barbarachbc/wilson-fuzz/README.md

# wilson-fuzz
Wilson Fuzz (a Fuzz Face clone)
