barbarachbc/wilson-fuzz/Production/25 - MouserBom.xls

Mfr Part Number (Input) | Quantity 1 | Mfr Part Number | Mouser Part Number | Manufacturer Name | Description | Unit Price 1 | Order Quantity | Order Unit Price | Min./Mult. | Availability | Lead Time in Days | Lead Time in Weeks | Lifecycle | NCNR | RoHS | Pb Free | Package Type | Package Quantity | Datasheet URL | Product Image | Design Risk
603-MFR25SFTF52-330R | 1
603-MFR25SFTF26-33K | 1
603-MFR25SFRF52-100K | 1
603-MFR25SFTF52-8K2 | 1
603-MFR25SFTF52-10K | 1
652-PDB181-E420K102B | 1 | PDB181-E420K-102B | 652-PDB181-E420K102B | Bourns | Potentiometers Potentiometers 1K SINGLE | €1.41 | 1 | €1.41 | 1\1 | 1,061 | 98 | 14 |  | No | Yes | Yes | TRAY | 50 | https://www.mouser.com/datasheet/2/54/PDB18-1013655.pdf |  | Product has high popularity and is readily available.
652-PDB181-E420K504B | 1
5164-1231-L | 2
512-BC549CTA | 2 | BC549CTA | 512-BC549CTA | onsemi | Bipolar Transistors - BJT Bipolar Transistors - BJT NPN 30V 100mA | €0.344 | 2 | €0.344 | 1\1 | 187,925 | 161 | 23 |  | No | Yes | Yes | AMMO PACK | 2,000 | https://www.mouser.com/datasheet/2/308/1/BC550_D-2310266.pdf |  | Product has high popularity and is readily available.
612-FS573PLT2B2M1QEH | 1 | FS57003PLT2B2M1QEH | 612-FS573PLT2B2M1QEH | E-Switch | Foot Switches Foot Switches PUSHBUTTON, 1A 9VDC, 3PDT On-On, Panel Mount, Rear Solder | €7.34 | 1 | €7.34 | 1\1 | 82 | 84 | 12 |  | No | Yes | Yes | BULK | 27 | https://configured-product-images.s3.amazonaws.com/2D/specs/FS57003PLT2B2M1QEH.pdf |  | Product has high popularity and is readily available.
502-111X | 2 | 111X | 502-111X | Switchcraft | Phone Connectors Phone Connectors 2C ENCLOSED 1/4" | €2.97 | 2 | €2.97 | 1\1 | 2,840 | 70 | 10 |  | No | Yes | No |  | 500 | https://www.mouser.com/datasheet/2/393/nl110x_mnl110x_series_cd-2943135.pdf |  | Product has high popularity and is readily available.
546-1590A | 1 | 1590A | 546-1590A | Hammond | Enclosures, Boxes, & Cases Enclosures, Boxes, & Cases Diecast Unpainted 3.64 x 1.52 x 1.06" | €7.65 | 1 | €7.65 | 1\1 | 1,060 |  |  |  | No | Yes | No |  | 1 | https://www.mouser.com/datasheet/2/177/1590-1283706.pdf |  | Product has high popularity and is readily available.
MFR-25FRF52-33K | 1 | MFR-25FRF52-33K | 603-MFR-25FRF52-33K | YAGEO | Metal Film Resistors - Through Hole Metal Film Resistors - Through Hole 33K OHM 1/4W 1% | €0.093 | 1 | €0.093 | 1\1 | 11,994 | 98 | 14 |  | No | Yes | Yes | REEL | 5,000 | https://www.mouser.com/datasheet/2/447/YAGEO_MFR_datasheet_2023v3-3324391.pdf |  | Product has high popularity and is readily available.
MFR-25FRF52-330R | 1 | MFR-25FRF52-330R | 603-MFR-25FRF52-330R | YAGEO | Metal Film Resistors - Through Hole Metal Film Resistors - Through Hole 330 OHM 1/4W 1% | €0.093 | 1 | €0.093 | 1\1 |  | 161 | 23 |  | No | Yes | Yes | REEL | 5,000 | https://www.mouser.com/datasheet/2/447/YAGEO_MFR_datasheet_2023v3-3324391.pdf |  | Product has high popularity and is readily available.
MFR-25FRF52-100K | 1 | MFR-25FRF52-100K | 603-MFR-25FRF52100K | YAGEO | Metal Film Resistors - Through Hole Metal Film Resistors - Through Hole 100K ohm 1/4W 1% | €0.093 | 1 | €0.093 | 1\1 | 28,105 | 161 | 23 |  | No | Yes | Yes | REEL | 5,000 | https://www.mouser.com/datasheet/2/447/YAGEO_MFR_datasheet_2023v3-3324391.pdf |  | Product has high popularity and is readily available.
MFR-25FRF52-8K2 | 1 | MFR-25FRF52-8K2 | 603-MFR-25FRF52-8K2 | YAGEO | Metal Film Resistors - Through Hole Metal Film Resistors - Through Hole 8.2K OHM 1/4W 1% | €0.093 | 1 | €0.093 | 1\1 | 15,995 | 168 | 24 |  | No | Yes | Yes | REEL | 5,000 | https://www.mouser.com/datasheet/2/447/YAGEO_MFR_datasheet_2023v3-3324391.pdf |  | Product has high popularity and is readily available.
MFR-25FRF52-10K | 1 | MFR-25FRF52-10K | 603-MFR-25FRF5210K | YAGEO | Metal Film Resistors - Through Hole Metal Film Resistors - Through Hole 10 kOhms 250 mW 1% 100 PPM / C | €0.093 | 1 | €0.093 | 1\1 |  | 70 | 10 |  | No | Yes | Yes | REEL | 5,000 | https://www.mouser.com/datasheet/2/447/YAGEO_MFR_datasheet_2023v3-3324391.pdf |  | Product has high popularity and is readily available.
710-860020672006 | 1 | 860020672006 | 710-860020672006 | Wurth Elektronik | Aluminum Electrolytic Capacitors - Radial Leaded Aluminum Electrolytic Capacitors - Radial Leaded WCAP-ATG5 2.2uF 50V 20% Radial | €0.102 | 1 | €0.102 | 1\1 | 4,833 | 31 | 5 |  | No | Yes | Yes | AMMO PACK | 2,000 | https://www.we-online.com/components/products/datasheet/860020672006.pdf |  | Product has high popularity and is readily available.
710-860020672011 | 1 | 860020672011 | 710-860020672011 | Wurth Elektronik | Aluminum Electrolytic Capacitors - Radial Leaded Aluminum Electrolytic Capacitors - Radial Leaded WCAP-ATG5 22uF 50V 20% Radial | €0.102 | 1 | €0.102 | 1\1 | 5,759 |  |  |  | No | Yes | Yes | AMMO PACK | 2,000 | https://www.we-online.com/components/products/datasheet/860020672011.pdf |  | Product has high popularity and is readily available.
710-860020472006 | 1 | 860020472006 | 710-860020472006 | Wurth Elektronik | Aluminum Electrolytic Capacitors - Radial Leaded Aluminum Electrolytic Capacitors - Radial Leaded WCAP-ATG5 47uF 25V 20% Radial | €0.093 | 1 | €0.093 | 1\1 | 17,221 |  |  |  | No | Yes | Yes | AMMO PACK | 2,000 | https://www.we-online.com/components/products/datasheet/860020472006.pdf |  | Product has high popularity and is readily available.
710-151031SS04000 | 1 | 151031SS04000 | 710-151031SS04000 | Wurth Elektronik | Standard LEDs - Through Hole Standard LEDs - Through Hole WL-TMRC THT Mono Diffusd Rnd3mm SprRd | €0.167 | 1 | €0.167 | 1\1 | 4,918 |  |  |  | No | Yes | Yes | BULK | 500 | https://www.we-online.com/components/products/datasheet/151031SS04000.pdf |  | Product has high popularity and is readily available.
871-B32529C103J | 1 | B32529C103J | 871-B32529C103J | TDK | Film Capacitors Film Capacitors 0.01uF 63volts 5% | €0.288 | 1 | €0.288 | 1\1 |  | 126 | 18 |  | No | Yes | Yes | BULK | 2,000 | https://www.tdk-electronics.tdk.com/inf/20/20/db/fc_2009/B32520_529.pdf |  | Product has high popularity and is readily available.
652-PDB181E415K504A2 | 1 | PDB181-E415K-504A2 | 652-PDB181E415K504A2 | Bourns | Potentiometers Potentiometers PANEL CONTROL 17MM-ST-CARBON | €1.42 | 1 | €1.42 | 1\1 | 533 | 98 | 14 |  | No | Yes | Yes | TRAY | 50 | https://www.mouser.com/datasheet/2/54/PDB18-1013655.pdf |  | Product has high popularity and is readily available.
836-10781 | 4 | 10781 | 836-10781 | Heyco | Standoffs & Spacers Standoffs & Spacers HCBS-08M-AB NATURAL NYL PCB Support ADH | €0.54 | 4 | €0.54 | 1\1 | 6,414 | 15 | 3 |  | No | Yes | No |  | 1,000 | https://www.mouser.com/datasheet/2/184/7-27_115-909012.pdf |  | Product has high popularity and is readily available.
652-PDB181-K420K102B | 1 | PDB181-K420K-102B | 652-PDB181-K420K102B | Bourns | Potentiometers Potentiometers 1K SINGLE | €1.41 | 1 | €1.41 | 1\1 | 785 | 98 | 14 |  | No | Yes | Yes | TRAY | 50 | https://www.mouser.com/datasheet/2/54/PDB18-1013655.pdf |  | Product has high popularity and is readily available.
652-PDB181-K420K504A | 1 | PDB181-K420K-504A | 652-PDB181-K420K504A | Bourns | Potentiometers Potentiometers 500K SINGLE | €1.15 | 1 | €1.15 | 1\1 | 352 | 98 | 14 |  | No | Yes | Yes | BULK | 75 | https://www.mouser.com/datasheet/2/54/PDB18-1013655.pdf |  | Product has high popularity and is readily available.
PJ-011A | 1 | PJ-011A | 490-PJ-011A | CUI Devices | DC Power Connectors DC Power Connectors Power Jacks | €1.88 | 1 | €1.88 | 1\1 | 2,555 | 91 | 13 |  | No | Yes | No |  | 300 | https://www.mouser.com/datasheet/2/670/pj_011a-1778135.pdf |  | Product has high popularity and is readily available.
5164-1227-L | 2 | 1227-L | 5164-1227-L | Davies Molding | Knobs & Dials Knobs & Dials S/T Control Knob 6mm Interference Fit | €1.53 | 2 | €1.53 | 1\1 | 947 | 4 | 1 |  | No | Yes | No |  | 100 | https://www.mouser.com/datasheet/2/102/1227-L-1287203.pdf |  | Product has high popularity and is readily available.
