barbarachbc/wilson-fuzz/Simulation/FuzzFace/FuzzFace - Silicon.asc

C1: polcap; 22µ
C4: polcap; 2.2µ
C5: cap; 0.01µ
Q1: npn; BC108C
Q2: npn; BC108C
R2: res; 100K
R3: res; 33K
R4: res; 330
R6: res; 8.2K
U1: pot; Rt=1K set={fuzz}; ""
U2: pot; Rt=500K set={level}; ""
V1: voltage; 9V
V2: voltage; SINE(0 0.1 1K); AC 1
Named nets: 0, IN, OUT
;.ac dec 10 1 100K
;.op
Fuzz Face - Sillicon Version
Sources:
https://fuzzcentral.ssguitar.com/fuzzface.php
http://geofex.com/article_folders/fuzzface/fftech.htm
http://diy.smallbearelec.com/HowTos/BreadboardSiFF/BreadboardSiFF.htm
.param fuzz=1 level=1
.tran 50m
.include ZTX851.spice
.include BC549.lib
.step param fuzz 0 1 0.1
Use BC108C, BC109C, BC549/550 or ZTX851 for Q1/Q2 value for example
.model BC108A NPN(Is=7.049f Xti=3 Eg=1.11 Vaf=116.3 Bf=375.5 Ise=7.049f Ne=1.281 Ikf=4.589 Nk=.5 Xtb=1.5 Br=2.611 Isc=121.7p Nc=1.865 Ikr=5.313 Rc=1.464 Cjc=5.38p Mjc=.329 Vjc=.6218 Fc=.5 Cje=11.5p Mje=.2717 Vje=.5 Tr=10n Tf=451p Itf=6.194 Xtf=17.43 Vtf=10 Vceo=30 Icrating=100m mfg=Philips)
.model BC108B NPN(Is=7.049f Xti=3 Eg=1.11 Vaf=59.59 Bf=381.7 Ise=59.74f Ne=1.522 Ikf=3.289 Nk=.5 Xtb=1.5 Br=2.359 Isc=192.9p Nc=1.954 Ikr=7.807 Rc=1.427 Cjc=5.38p Mjc=.329 Vjc=.6218 Fc=.5 Cje=11.5p Mje=.2718 Vje=.5 Tr=10n Tf=438p Itf=5.716 Xtf=14.51 Vtf=10 Vceo=30 Icrating=100m mfg=Philips)
.model BC108C NPN(Is=7.049f Xti=3 Eg=1.11 Vaf=28.14 Bf=677 Ise=7.049f Ne=1.38 Ikf=96.23 Nk=.5 Xtb=1.5 Br=2.209 Isc=250.3p Nc=2.002 Ikr=10.73 Rc=1.433 Cjc=5.38p Mjc=.329 Vjc=.6218 Fc=.5 Cje=11.5p Mje=.2717 Vje=.5 Tr=10n Tf=437.8p Itf=3.097 Xtf=12.85 Vtf=10 Vceo=30 Icrating=100m mfg=Philips)
.model BC109B NPN(Is=7.049f Xti=3 Eg=1.11 Vaf=59.59 Bf=381.7 Ise=59.74f Ne=1.522 Ikf=3.289 Nk=.5 Xtb=1.5 Br=2.359 Isc=192.9p Nc=1.954 Ikr=7.807 Rc=1.427 Cjc=5.38p Mjc=.329 Vjc=.6218 Fc=.5 Cje=11.5p Mje=.2718 Vje=.5 Tr=10n Tf=438p Itf=5.716 Xtf=14.51 Vtf=10 Vceo=30 Icrating=100m mfg=Philips)
.model BC109C NPN(Is=7.049f Xti=3 Eg=1.11 Vaf=28.14 Bf=677 Ise=7.049f Ne=1.38 Ikf=96.23 Nk=.5 Xtb=1.5 Br=2.209 Isc=250.3p Nc=2.002 Ikr=10.73 Rc=1.433 Cjc=5.38p Mjc=.329 Vjc=.6218 Fc=.5 Cje=11.5p Mje=.2717 Vje=.5 Tr=10n Tf=437.8p Itf=3.097 Xtf=12.85 Vtf=10 Vceo=30 Icrating=100m mfg=Philips)
https://ltwiki.org/?title=Components_Library_and_Circuits
(standard.bjt)
