barbarachbc/wilson-fuzz/Hardware/WilsonFuzz/WilsonFuzz.kicad_pcb

## KiCad design Hardware/WilsonFuzz/WilsonFuzz.kicad_pcb (2024-04-01)

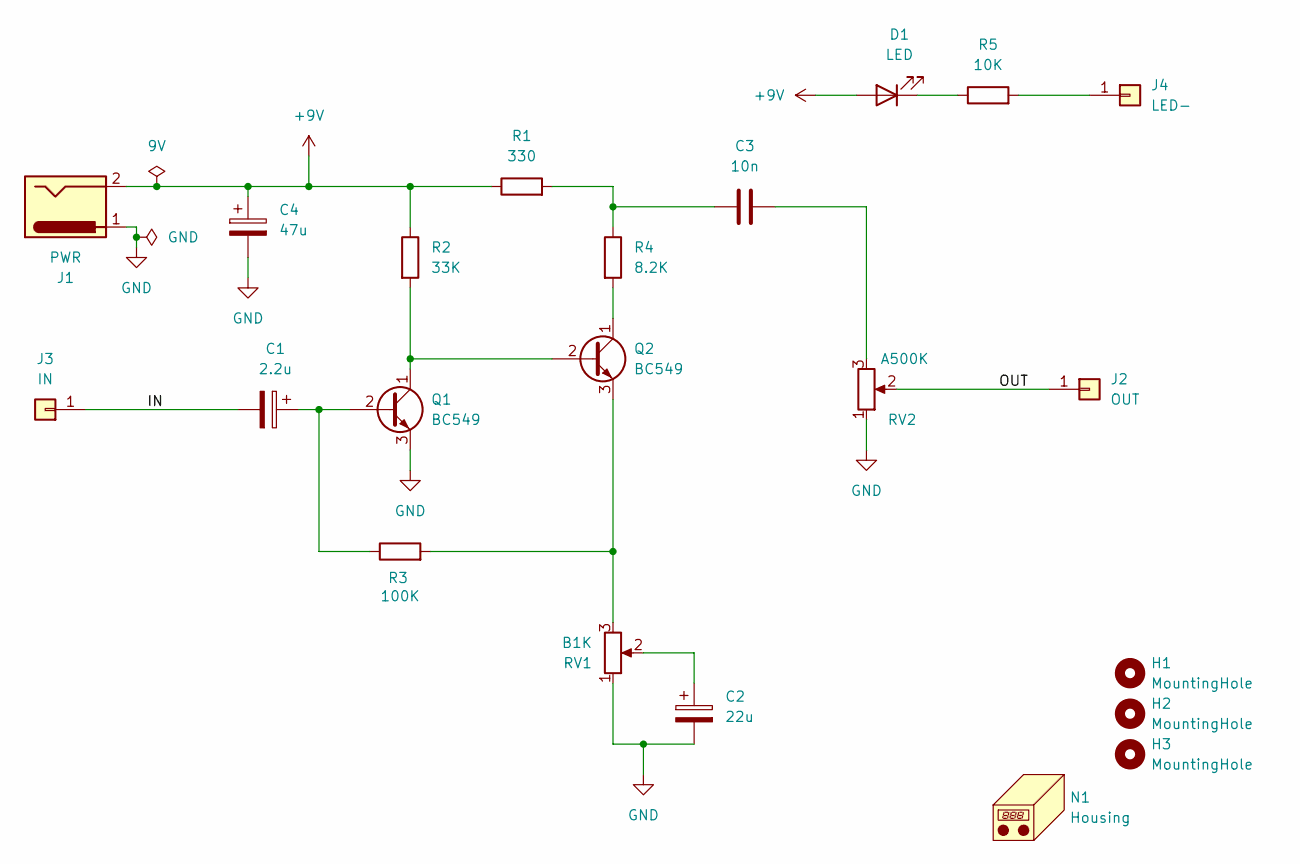
[picture p1: schematic WilsonFuzz.kicad_sch, Wilson Fuzz]

Parts:
C1: 2.2u; CP_Radial_D5.0mm_P2.00mm
C2: 22u; CP_Radial_D5.0mm_P2.00mm
C3: 10n; C_Rect_L7.2mm_W2.5mm_P5.00mm_FKS2_FKP2_MKS2_MKP2
C4: 47u; CP_Radial_D5.0mm_P2.00mm
D1: LED; LED_D3.0mm
H1, H2, H3: MountingHole; MountingHole_4mm
J1: PWR; PinHeader_1x02_P2.54mm_Vertical
J2: OUT; PinHeader_1x01_P2.54mm_Vertical
J3: IN; PinHeader_1x01_P2.54mm_Vertical
J4: LED-; PinHeader_1x01_P2.54mm_Vertical
N1: Housing; Barbarach_Smaller
Q1, Q2: BC549; TO-92_Inline_Wide
R1: 330; R_Axial_DIN0207_L6.3mm_D2.5mm_P7.62mm_Horizontal
R2: 33K; R_Axial_DIN0207_L6.3mm_D2.5mm_P7.62mm_Horizontal
R3: 100K; R_Axial_DIN0207_L6.3mm_D2.5mm_P7.62mm_Horizontal
R4: 8.2K; R_Axial_DIN0207_L6.3mm_D2.5mm_P7.62mm_Horizontal
R5: 10K; R_Axial_DIN0207_L6.3mm_D2.5mm_P7.62mm_Horizontal
RV1: B1K; PDB181K420K102B
RV2: A500K; PDB181K420K102B

Connections:
+9V: C4.1, D1.2 (A), J1.2, R1.1, R2.1
/IN: C1.2, J3.1
/OUT: J2.1, RV2.2
GND: C2.2, C4.2, J1.1, Q1.3 (E), RV1.1, RV2.1
unnamed: C2.1, RV1.2
unnamed: C3.1, R1.2, R4.1
unnamed: C3.2, RV2.3
unnamed: D1.1 (K), R5.1
unnamed: J4.1, R5.2
unnamed: C1.1, Q1.2 (B), R3.1
unnamed: Q1.1 (C), Q2.2 (B), R2.2
unnamed: Q2.1 (C), R4.2
unnamed: Q2.3 (E), R3.2, RV1.3

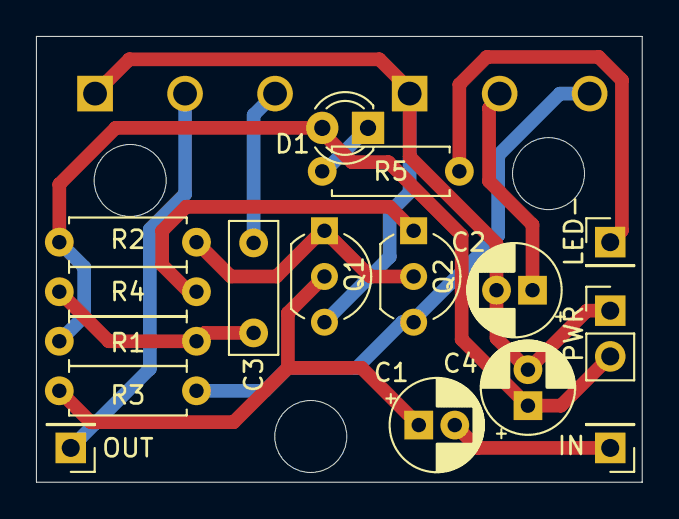
[picture p2: board WilsonFuzz.kicad_pcb from above]

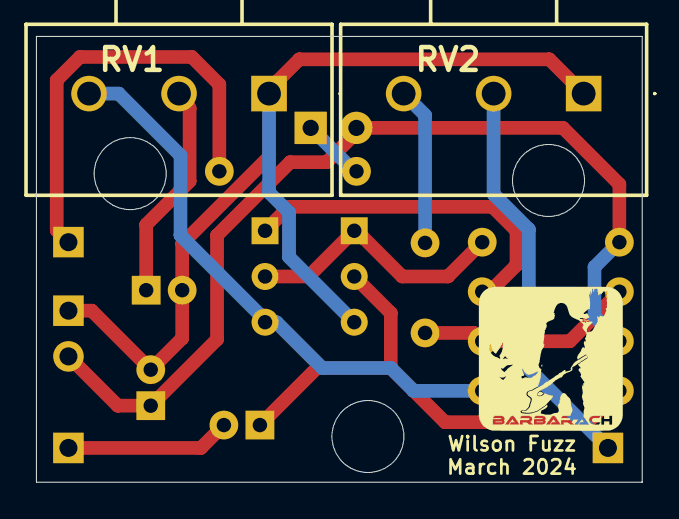
[picture p3: board WilsonFuzz.kicad_pcb from below]

Board: 2 copper layers, 33.7 x 24.8 mm, 22 parts (3 on the bottom side), 13 nets.
