barbarachbc/wilson-fuzz/(commit log)

2024-04-04 Adding BOM. Fixing gitignore to exclude lck files
    [25 - MouserBom.xls]
2024-05-29 Adding graphics and drilling planner
2024-05-30 Updated bom with different dc jack and knobs
    [25 - MouserBom.xls]
2024-09-02 1590B enclosure drill template
